H-Najjar94/scale/decoder_verification.csv

time_s | packet_hex | raw_le24
0.003426 | 02 62 0C 00 80 AA | 3170
0.023064 | 02 62 0C 00 80 AA | 3170
0.042762 | 02 62 0C 00 80 AA | 3170
0.062707 | 02 62 0C 00 80 AA | 3170
0.082582 | 02 63 0C 00 80 AA | 3171
0.102362 | 02 63 0C 00 80 AA | 3171
0.122117 | 02 64 0C 00 80 AA | 3172
0.141827 | 02 64 0C 00 80 AA | 3172
0.161656 | 02 65 0C 00 80 AA | 3173
0.181419 | 02 66 0C 00 80 AA | 3174
0.201125 | 02 67 0C 00 80 AA | 3175
0.220855 | 02 68 0C 00 80 AA | 3176
0.240643 | 02 68 0C 00 80 AA | 3176
0.260369 | 02 68 0C 00 80 AA | 3176
0.280073 | 02 68 0C 00 80 AA | 3176
0.299725 | 02 68 0C 00 80 AA | 3176
0.319586 | 02 68 0C 00 80 AA | 3176
0.339464 | 02 68 0C 00 80 AA | 3176
0.359361 | 02 68 0C 00 80 AA | 3176
0.379269 | 02 68 0C 00 80 AA | 3176
0.399181 | 02 67 0C 00 80 AA | 3175
0.419016 | 02 66 0C 00 80 AA | 3174
0.438989 | 02 65 0C 00 80 AA | 3173
0.458662 | 02 64 0C 00 80 AA | 3172
0.478355 | 02 63 0C 00 80 AA | 3171
0.498057 | 02 62 0C 00 80 AA | 3170
0.517744 | 02 61 0C 00 80 AA | 3169
0.537439 | 02 61 0C 00 80 AA | 3169
0.557125 | 02 61 0C 00 80 AA | 3169
0.576866 | 02 61 0C 00 80 AA | 3169
0.596693 | 02 61 0C 00 80 AA | 3169
0.616494 | 02 61 0C 00 80 AA | 3169
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
