H-Najjar94/scale/scale_load_test_packets.csv

time_s | packet_hex | raw_le24
0.006458 | 02 62 0C 00 80 AA | 3170
0.026364 | 02 62 0C 00 80 AA | 3170
0.046260 | 02 62 0C 00 80 AA | 3170
0.065968 | 02 62 0C 00 80 AA | 3170
0.085756 | 02 62 0C 00 80 AA | 3170
0.105581 | 02 62 0C 00 80 AA | 3170
0.125392 | 02 62 0C 00 80 AA | 3170
0.145175 | 02 62 0C 00 80 AA | 3170
0.164971 | 02 62 0C 00 80 AA | 3170
0.184679 | 02 62 0C 00 80 AA | 3170
0.204527 | 02 62 0C 00 80 AA | 3170
0.224438 | 02 62 0C 00 80 AA | 3170
0.244130 | 02 62 0C 00 80 AA | 3170
0.263816 | 02 62 0C 00 80 AA | 3170
0.283530 | 02 62 0C 00 80 AA | 3170
0.303536 | 02 62 0C 00 80 AA | 3170
0.323422 | 02 62 0C 00 80 AA | 3170
0.343156 | 02 62 0C 00 80 AA | 3170
0.363119 | 02 62 0C 00 80 AA | 3170
0.383044 | 02 62 0C 00 80 AA | 3170
0.402979 | 02 62 0C 00 80 AA | 3170
0.422843 | 02 62 0C 00 80 AA | 3170
0.442615 | 02 62 0C 00 80 AA | 3170
0.462354 | 02 62 0C 00 80 AA | 3170
0.482178 | 02 62 0C 00 80 AA | 3170
0.501990 | 02 63 0C 00 80 AA | 3171
0.521815 | 02 64 0C 00 80 AA | 3172
0.541585 | 02 65 0C 00 80 AA | 3173
0.561318 | 02 66 0C 00 80 AA | 3174
0.581037 | 02 67 0C 00 80 AA | 3175
0.600781 | 02 68 0C 00 80 AA | 3176
0.620500 | 02 69 0C 00 80 AA | 3177
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
