H-Najjar94/scale/(commit log)

2026-09-12 Add FNC-SCALE Bluetooth scale app and ESP32 bridge
    [decoder_verification.csv, scale_cold_start_packets.csv, scale_load_test_packets.csv, scale_stationary_10s_packets.csv]
2026-09-12 Stabilize repeated scale measurements
    [scale_spi_ble_bridge.ino]
2026-09-12 Test calibration filtering and complete sampling windows
2026-09-13 Allow stable light-load calibration
2026-09-13 Verify calibration repeatability before saving
